JoshuaSLE/esp32h2-zb-env-mon/firmware/components/bme280/include/bme280_defs.h

#pragma once

#define BME280_REG_ID 0xD0
#define BME280_REG_RESET 0xE0
#define BME280_REG_CTRL_HUM 0xF2
#define BME280_REG_STATUS 0xF3
#define BME280_REG_CTRL_MEAS 0xF4
#define BME280_REG_CONFIG 0xF5
#define BME280_REG_PRESS 0xF7
#define BME280_REG_TEMP 0xFA
#define BME280_REG_HUM 0xFE

#define BME280_REG_CALIB00 0x88
#define BME280_REG_CALIB26 0xE1

#define BME280_ID_VAL 0x60
#define BME280_SOFT_RESET_VAL 0xB6

#define BME280_STATUS_MEAS BIT(3)
#define BME280_STATUS_UPDATE BIT(0)

#define BME280_MIN_TEMP -40
#define BME280_MAX_TEMP 85

#define BME280_MIN_PRESS 300
#define BME280_MAX_PRESS 1100

#define BME280_MIN_HUM 0
#define BME280_MAX_HUM 100
