JoshuaSLE/esp32h2-zb-env-mon/firmware/main/zigbee.h

#pragma once

#include "bme280.h"

#include "esp_err.h"

#ifdef __cplusplus
extern "C"
{
#endif

    /**
     * @brief Initialize Zigbee stack, register signal handler, create data model.
     *
     * @return esp_err_t
     */
    esp_err_t zigbee_init(void);

    /**
     * @brief Report the BME280 readings.
     *
     * @param reading BME280 readings data.
     */
    void zigbee_report_bme280(const bme280_data_t *reading);

    /**
     * @brief Sends a Zigbee leave request, erases NVS network credentials, and soft-resets the MCU.
     * 
     */
    void zigbee_factory_reset(void);

#ifdef __cplusplus
}
#endif
