JoshuaSLE/esp32h2-zb-env-mon/firmware/components/vcnl4010/include/vcnl4010_def.h

#pragma once

#define VCNL4010_I2C_ADDR 0x13

#define VCNL4010_REG_COMMAND 0x80
#define VCNL4010_REG_PRODUCT_ID 0x81
#define VCNL4010_REG_PROX_RATE 0x82
#define VCNL4010_REG_LED_CURRENT 0x83
#define VCNL4010_REG_ALS_PARAM 0x84
#define VCNL4010_REG_ALS_RESULT 0x85
#define VCNL4010_REG_PROX_RESULT 0x87
#define VCNL4010_REG_INT_CTRL 0x89
#define VCNL4010_REG_LOW_THRES 0x8A
#define VCNL4010_REG_HIGH_THRES 0x8C
#define VCNL4010_REG_INT_STATUS 0x8E
#define VCNL4010_REG_PROX_ADJUST 0x8F

#define VCNL4010_CMD_SELFTIMED_EN BIT(0)
#define VCNL4010_CMD_PROX_EN BIT(1)
#define VCNL4010_CMD_ALS_EN BIT(2)
#define VCNL4010_CMD_PROX_OD BIT(3)
#define VCNL4010_CMD_ALS_OD BIT(4)
#define VCNL4010_CMD_PROX_DATA_RDY BIT(5)
#define VCNL4010_CMD_ALS_DATA_RDY BIT(6)
#define VCNL4010_CMD_CONFIG_LOCK BIT(7)

#define VCNL4010_PRODUCT_ID 0x21

#define VCNL4010_ALS_AUTO_OFFSET_EN BIT(3)
#define VCNL4010_ALS_AUTO_OFFSET_DIS 0x00

#define VCNL4010_INT_THRES_SEL_ALS BIT(0) // 0 = Prox, 1 = ALS
#define VCNL4010_INT_THRES_EN BIT(1)
#define VCNL4010_INT_ALS_READY BIT(2)
#define VCNL4010_INT_PROX_READY BIT(3)

#define VCNL4010_INT_STATUS_HIGH BIT(0)
#define VCNL4010_INT_STATUS_LOW BIT(1)
#define VCNL4010_INT_STATUS_ALS_READY BIT(2)
#define VCNL4010_INT_STATUS_PROX_READY BIT(3)
