JoshuaSLE/esp32h2-zb-env-mon/(commit log)

2026-09-15 Refactor sensor monitoring into app modules
    Split the app startup and sensor logic into dedicated modules, replacing the old env_mon/presence implementation with app_main and sensor_manager. This adds central sensor event queuing for Zigbee, initializes the LCD and I2C bus in the new flow, and introduces periodic BME280 sampling with presence-triggered display wakeups and timeout handling. The display code was also updated to clear the framebuffer on init and to use corrected power helpers and status formatting.
    [app_main.c, display.c, display.h]
2026-09-15 Sensor manager: split BME280 into periodic task
    Refactor presence manager into a sensor_manager that decouples BME280 sampling from motion/display handling. Introduces a dedicated bme280_task (60s tick-driven sampling), a cached_reading with portMUX lock and dirty flag, and a presence_task that drives display on/off and redraws when new data arrives. API changes: presence_init renamed to sensor_manager_init; added sensor_manager_set_display_timeout_ms and DISPLAY_TIMEOUT_MIN/MS/MAX. Fixes post_zigbee_event null-check bug and ensures both tasks are created before returning. Header updated accordingly.
    [app_main.c]
2026-09-15 Fix display_off logic; add partitions.csv
    Correct display_off to pass the proper flag to display_off_on (was passing true; now passes false) to ensure the panel is actually turned off. Add firmware/partitions.csv containing the partition table (nvs, otadata, phy_init, ota_0/1, zb_storage, zb_fct) for flashing and OTA layout.
    [partitions.csv]
2026-09-16 Add Zigbee retry timer and partition config
    This change adds a reusable alarm timer for delayed Zigbee commissioning retries and integrates it into the app signal handler for initialization and network steering recovery. It also updates the build to include the new timer module and required NVS/ESP timer dependencies. The flash partition table was simplified to a factory app layout with dedicated Zigbee NVS and FAT storage regions for the ESP32-H2 Zigbee stack.
    [partitions.csv]
2026-09-16 Register environmental monitor ZCL device
    Add a dedicated Zigbee environmental monitor device descriptor and endpoint, including manufacturer and model attributes in the Basic cluster. Register the device during stack startup so the app advertises the new ZCL model on the network.
2026-09-18 Add Zigbee device and display timeout cluster
    Integrates Zigbee environmental monitor: renames zigbee_init to app_zigbee_init and calls it from app_main. Adds app_zigbee.h constants for device/cluster/attribute IDs. Builds and registers ZCL cluster descriptors (Basic, Identify, Temperature, Humidity, Pressure, and a custom display-timeout cluster) and endpoint, with attribute registration. Implements custom cluster callbacks to validate and apply a writable DISPLAY_TIMEOUT attribute via sensor_manager_set_display_timeout_ms. Also includes necessary header additions and minor refactoring to hook sensor_manager into the new cluster behavior.
2026-09-21 Refactor Zigbee module; simplify display timeout
    Replace app_zigbee.c/h with a new zigbee.c/h implementation and update CMakeLists and app_main to use zigbee_init(). The new Zigbee module centralizes stack setup, commissioning handlers and a simplified data model. Remove the runtime-configurable display timeout: sensor_manager now uses CONFIG_APP_DISPLAY_TIMEOUT_MS and the sensor_manager_set_display_timeout_ms API and related defines were removed. Also apply small wording tweaks to README and TIMELINE. These changes simplify Zigbee code and remove the custom cluster/attr used to change display timeout at runtime.
    [app_main.c, zigbee.c, zigbee.h]
2026-09-22 Report BME280 readings over Zigbee
    Send BME280 sensor updates as Zigbee ZCL attribute reports. sensor_manager.c now includes zigbee.h and calls zigbee_report_bme280() after each BME280 reading. zigbee.h gains the bme280 include and declaration for zigbee_report_bme280(). zigbee.c implements zigbee_report_bme280(): acquires the Zigbee lock, converts sensor units to ZCL formats, updates temperature/humidity/pressure attributes, and issues report commands. Also renamed endpoint macro to ENV_MONITOR_EP_ID and added a ZCL attribute ID macro. Enables automatic reporting of environmental measurements when readings update.
    [zigbee.c, zigbee.h]
2026-09-22 Improve Zigbee low-power behavior
    Enable ESP-IDF power management and light sleep defaults for the firmware, and initialize PM before starting peripherals. This also updates the Zigbee stack configuration to disable RX-on-when-idle, uses the unknown power source for the basic cluster, and fixes string attribute handling and sensor reporting edge cases. It includes a null guard for BME280 reads and corrects the pressure field type to avoid invalid reports.
    [app_main.c, zigbee.c]
2026-09-23 Fix sensor timing and Zigbee startup
    This change stabilizes the BME280 forced-measure flow by waiting for the measurement status bits instead of relying on a fixed delay, and fixes the VCNL4010 init validation bug. It also removes the unused Zigbee queue plumbing, updates the presence interrupt logic and display wake behavior, and enables GPIO-based sleep wakeups for motion detection. Finally, Zigbee startup now waits for the stack to be ready and skips invalid or out-of-range sensor reports to avoid dropped updates.
    [app_main.c, bme280.c, display.h, vcnl4010.c, zigbee.c]
2026-09-23 Centralize VCNL4010 I2C addr; add app config options
    Introduce VCNL4010_I2C_ADDR and remove per-instance i2c_address from vcnl4010_config; vcnl4010 now uses the centralized define. Update sensor_manager to use a runtime display_timeout_ms (from CONFIG) and stop passing the removed i2c address. Expand I2C SDA/SCL GPIO ranges to 0-27. Add Input (reset) GPIO config. Add display timeout min/max and enforce the range for CONFIG_APP_DISPLAY_TIMEOUT_MS. Add Rotary Encoder configs (invert, A/B GPIOs). Adjust VCNL4010 INT GPIO default and range and add a warning about boot-mode strapping pins.
    [vcnl4010.c, vcnl4010.h, vcnl4010_def.h]
2026-09-24 Tune Zigbee energy and sampling config
    This change updates the firmware to use a configurable 60s-300s BME280 polling interval and aligns power-save settings with the default CPU frequency. It also simplifies Zigbee startup by removing the stack-ready semaphore wait, enabling low-power RX settings, and retrying commissioning with a 5s alarm schedule. The default SDK config now enables Zigbee end-device sleep support and light-sleep related options for lower-power operation.
2026-09-24 Tune Zigbee and sensor power settings
    Update board GPIO defaults and remove obsolete display timeout config while tuning sensor behavior for the current hardware. This change also configures Zigbee channel masks, extends the end-device idle timeout, and only reports BME280 data once the network is connected. Additional power-management flags were enabled for light sleep and the proximity polling rate was adjusted to improve battery-life behavior.
2026-09-24 Refactor sensor tasks into task manager
    Replaced the monolithic sensor manager with a task-based manager that separates BME280 sampling, VCNL4010 wakeup handling, and display timing. The display now reacts to fresh readings and motion events via task notifications, and Zigbee connection state handling was updated to account for leave events safely.
    [app_main.c, task_manager.c, task_manager.h, zigbee.c]
2026-09-26 Add display timeout controls and Zigbee robustness
    This commit updates the project docs and wiring guidance, adds cached-display timeout cycling and reset handling in the task manager, and tightens the BME280/Zigbee data model validation. It also improves Zigbee steering and reporting reliability, adds a factory-reset action, and refreshes the ESP32-H2 firmware configuration for the current build.
    [bme280_defs.h, display.c, display.h, task_manager.c, task_manager.h, zigbee.c, zigbee.h]
2026-10-15 Scaffold KiCad project and update workspace
    Add initial schematic, PCB, and project files for the ESP32-H2 environmental monitor. Update the VS Code workspace name and recommend the CMake Tools and ESP-IDF extensions.
